Mustafa-Shady/Autonomous_Green_House/README.md

# Autonomous_Green_House
Developing a system that can help farmers optimize crop growth and yield by monitoring and controlling environmental factors like temperature, humidity, and soil moisture using IOT.
