Mustafa-Shady/Autonomous_Green_House/Book _ Presentation/graduation project.pptx

## Autonomous Green House Control System

## Group members

1. Saad Mohammed
2. Mostafa Mohammed
3. Youssef Hamad
4. Mostafa Mahmoud
5. Mohammed Tharwat
6. Mostafa Essam

## Why this project ?

- Greenhouses are important in Egypt due to the country's arid climate, limited water resources, and high population growth, they offer a means of improving crop yields, reducing resource consumption, and providing food security for the growing population.

## Timeline

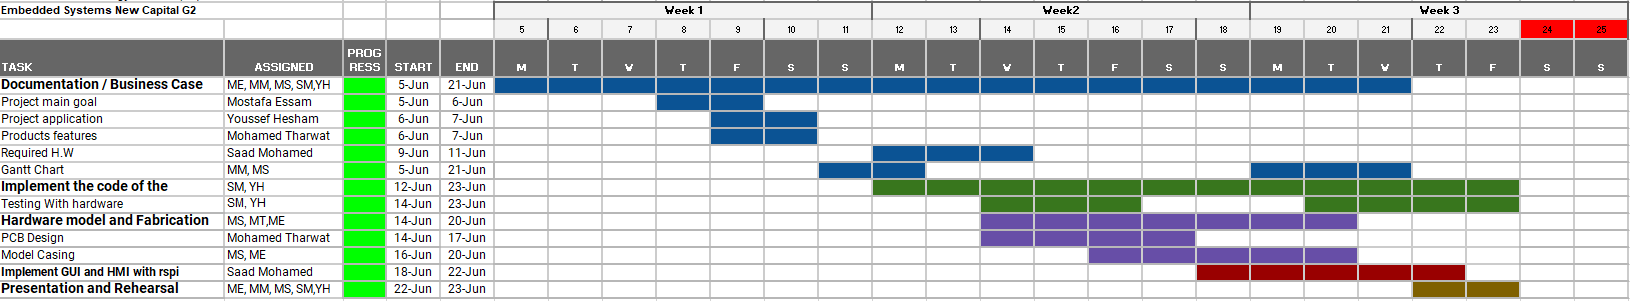
[picture p1: figure]

## Project main goal

- The main goal of this project is to develop a smart greenhouse
system to help users optimize crop growth by monitoring and
controlling environmental factors.

## Project features

1- Automated control: The system uses actuators. such as fans, heaters, and
pumps, to automate controlling of the environment
2- Environmental monitoring: The system uses a network of sensors to monitor
environmental factors such as temperature, humidity, and soil moisture in real-
time and show data on an LCD screen.
3- Remotely monitoring: the system
will send the status of the greenhouse
to an IOT server.

## System Flowchart

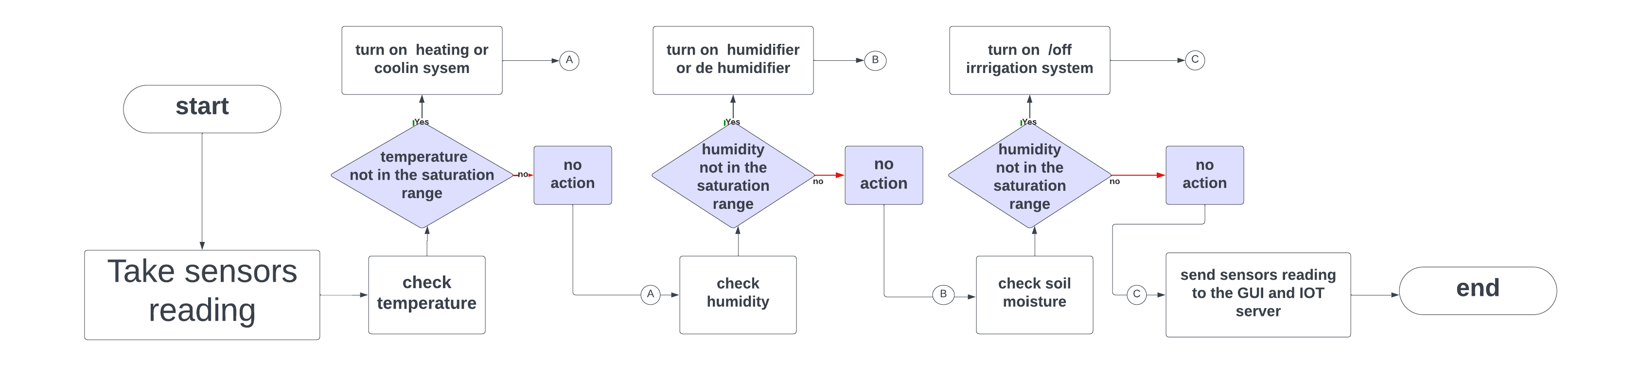
[picture p2: figure]

## Project prototype

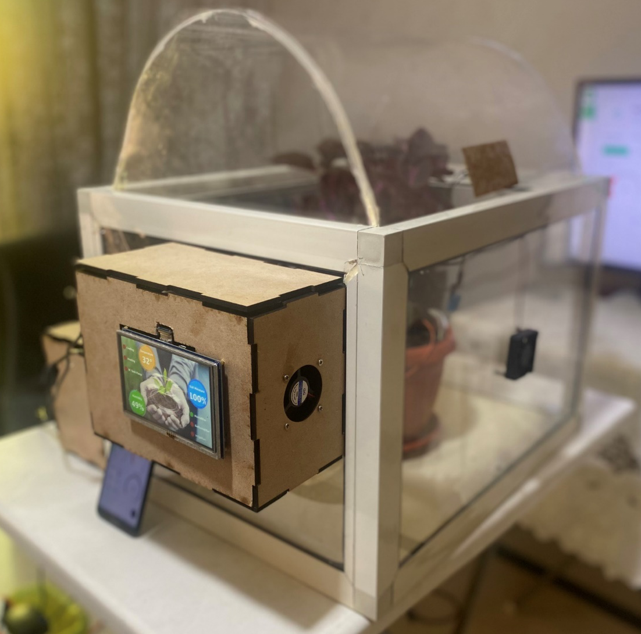
[picture p3: figure]
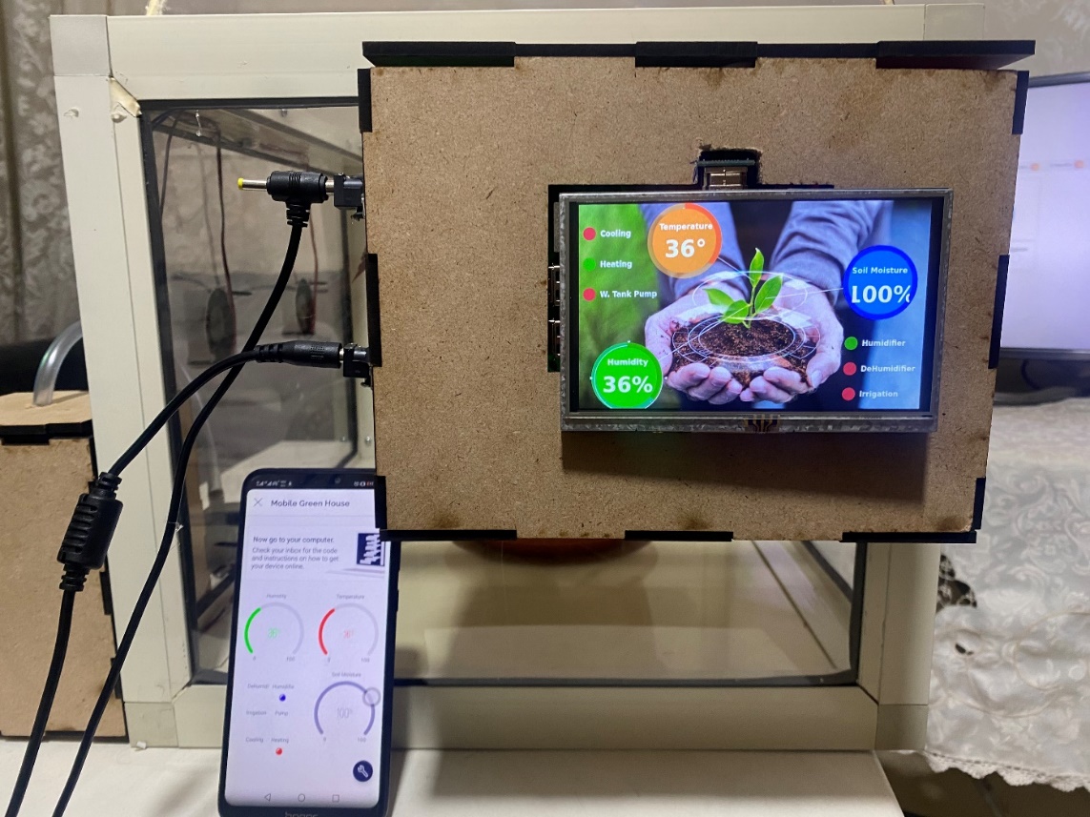
[picture p4: figure]

## Hardware

- Microcontrollers
1-STM32F401CCU6
2-Raspberry Pi 3 Model B+
3- Node Mcu

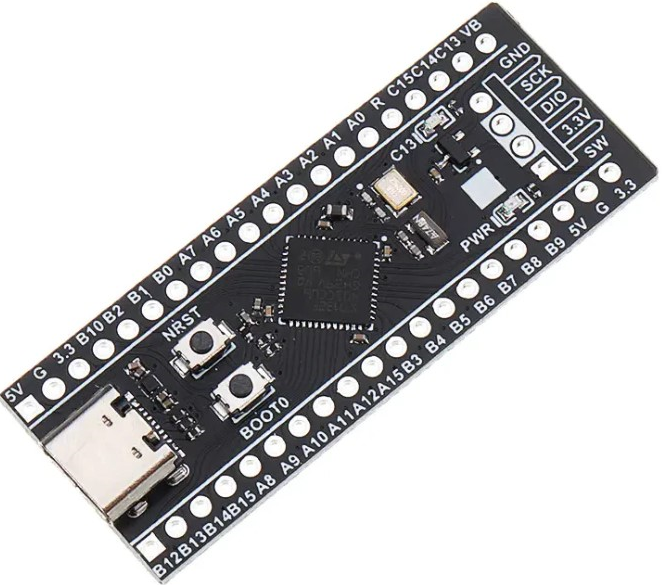
[picture p5: figure]
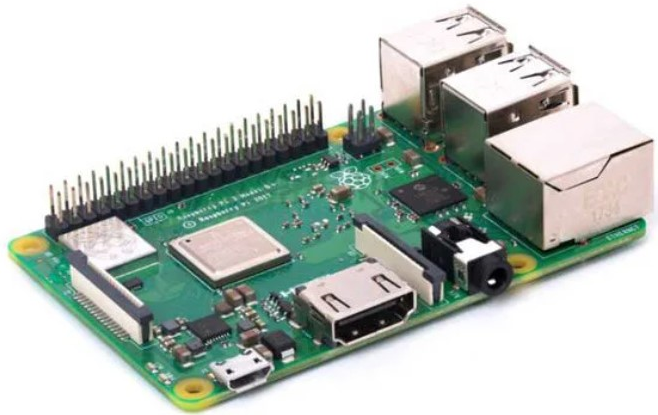
[picture p6: figure]
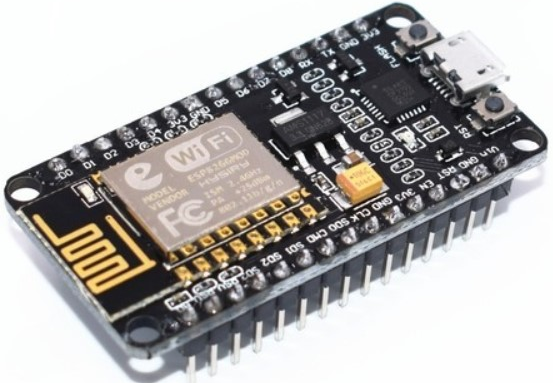
[picture p7: figure]

## Hardware

- Sensors
1- DH11 sensor
2-Soil Moisture Sensor
3-water level sensor

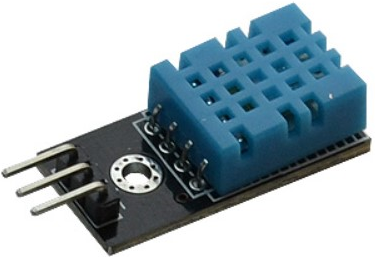
[picture p8: figure]
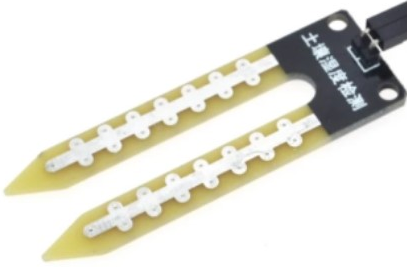
[picture p9: figure]
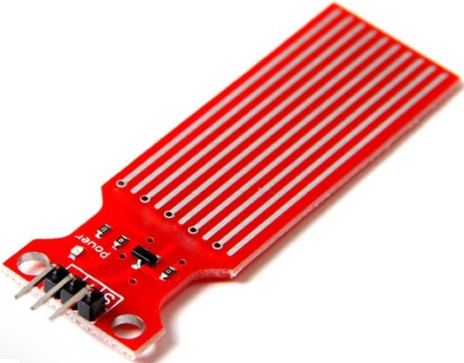
[picture p10: figure]

## Hardware

- Actuators
1-12v Pump
2- 12v fan
3- 5v heating pad

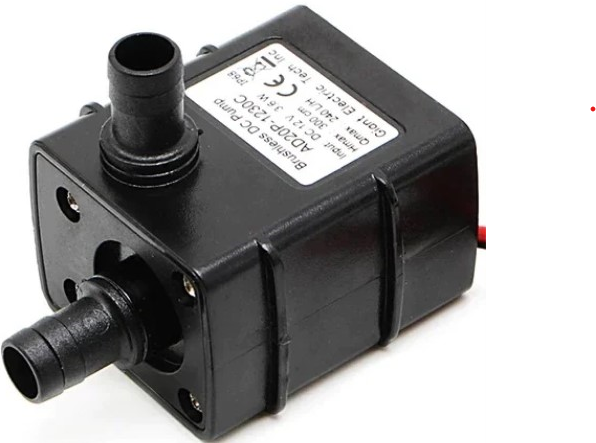
[picture p11: figure]
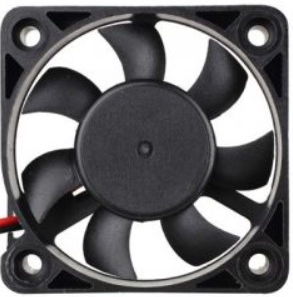
[picture p12: figure]
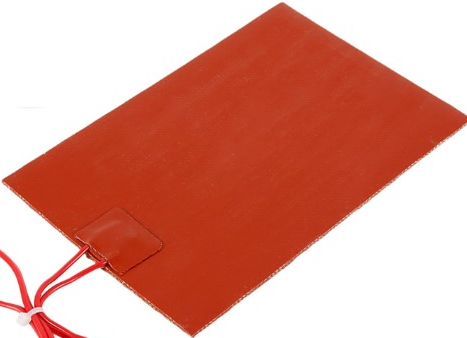
[picture p13: figure]

## Hardware

4- PCB

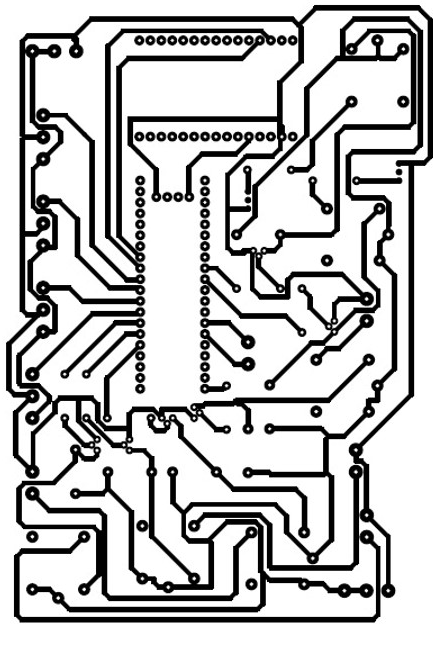
[picture p14: figure]
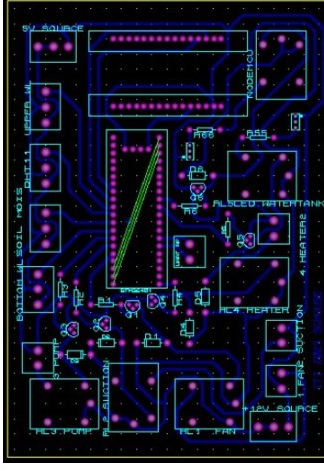
[picture p15: figure]
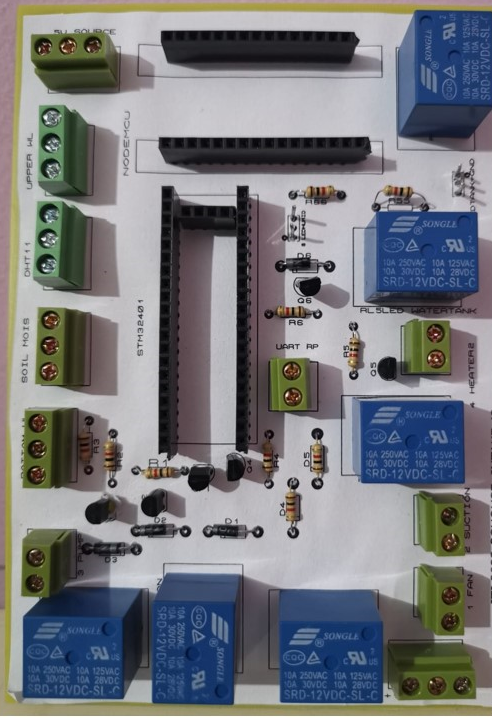
[picture p16: figure]

## Software

  - Three programming languages were used.
1- C language.

- Used to configure STM32F401CCU6 to automate the process and send the data to GUI, IOT systems.
- FreeRTOS was used as an operating system.

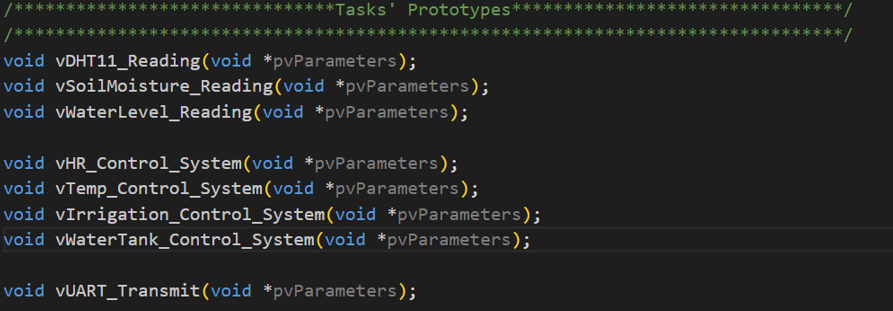
[picture p17: figure]

## Software

2-Python
Used to create the GUI system and update data shown by GUI periodically.

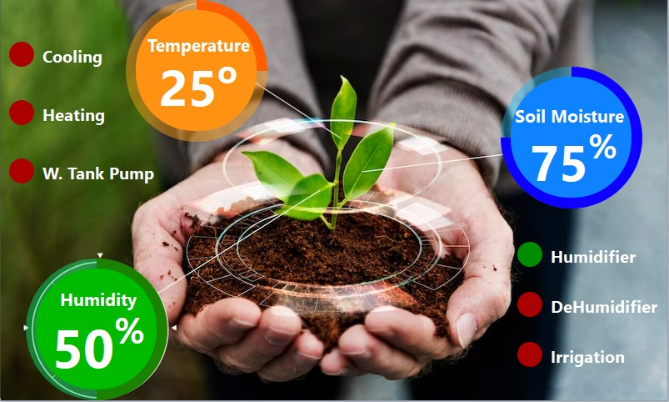
[picture p18: figure]

## Software

3- Arduino C
Set up node MCU to handle communication between STM32F401CCU6 and IOT server.

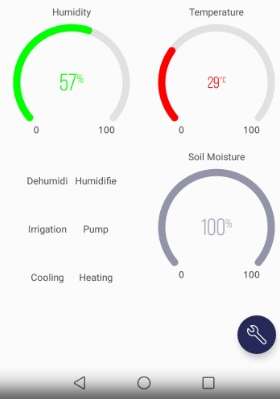
[picture p19: figure]

## Future work

- Add manual mode for the user to control fans, water pump and heaters.
- Add mode for the user to change the system configurations.
- Make these modes available to use through GUI screen and IOT application.

## Test cases

To see test cases press here (https://docs.google.com/spreadsheets/d/1YgNEVHUtksqQ6XoSTe12LOkKqpy5VTSK/edit#gid=343586251)

## Demo video

To see demo video press here (https://drive.google.com/file/d/1VSRbYElWp8d7YfNHoQmX-cIIlgPggJjG/view?usp=drive_link)

## THANKS
