Mustafa-Shady/Autonomous_Green_House/Documents/State Machine Diagram.png

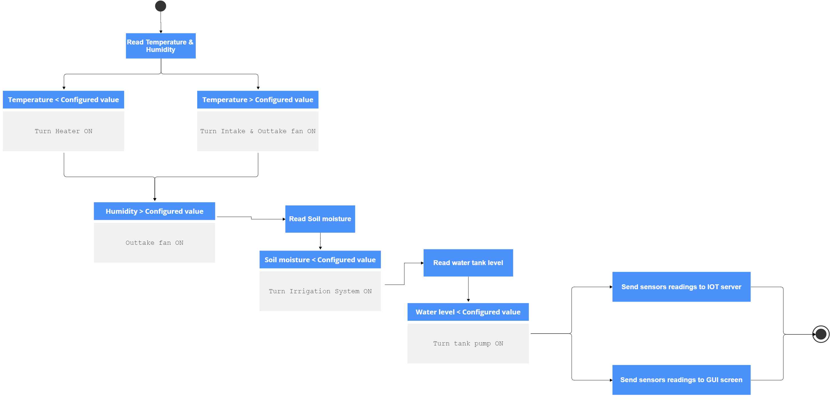
Documents/State Machine Diagram.png
