Mustafa-Shady/Autonomous_Green_House/Documents/Required Hardware.xlsx

No | Qty | Name
1 | 1 | STM32F401
2 | 1 | Soil/Moisture Sensor
3 | 1 | Humdity/Temp Sensor
4 | 2 | Water level Sensors
5 | 1 | Water Pump
6 | 1 | Plant pot
7 | 1 | Rasp Pi B Model
8 | 1 | LCD HMI Screen
9 | 1 | WIFI Module
10 | 4 | Relays
