Mustafa-Shady/Autonomous_Green_House/Documents/Project budget_.xlsx

No. | Qty | Name | Price | Total
1 | 1 | STM32F401 | 300 | 300
2 | 1 | Soil/Moisture Sensor | 190 | 190
3 | 1 | Humdity/Temp Sensor | 175 | 175
4 | 2 | Water level Sensors | 40 | 80
5 | 1 | Water Pump | 90 | 90
6 | 1 | Plant pot | 200 | 200
7 | 1 | Rasp Pi B Model | 6000 | 6000
8 | 1 | LCD HMI Screen | 2000 | 2000
9 | 1 | WIFI Module | 300 | 300
10 | 4 | Relays | 45 | 180
11 | 1 | Casing(Packaging) | 350 | 350
Total |  |  |  | 9865
