Mustafa-Shady/Autonomous_Green_House/Documents/Test_Cases.xlsx

Test case ID. | Test Case Description | Test Steps | Test Data | Expected Results | Actual Results | Pass/Fail
SY01 | Check Irrigation System Activation | Apply SoilMoisture Sensor to a dry Soil. | soil with Moisture Less than 40% | Activation of Irrigation System | As Expected | Pass
SY02 | Check Irrigation System Deactivation | Apply SoilMoisture Sensor to a wet Soil. | soil with Moisture More than 80% | Deactivation of Irrigation System | As Expected | Pass
SY03 | Check Humidifier System Activation | Apply DH11 Sensor to a dry atmosphere. | Atmosphere with Humidity less than 40% | Activation of Humidifier System | As Expected | Pass
SY04 | Check Humidifier System DeActivation | Apply DH11 Sensor to a Less Dry atmosphere. | Atmosphere with Humidity less than 50% | Deactivation of Humidifier System | As Expected | Pass
SY05 | Check Dehumidifier System Activation | Apply DH11 Sensor to a wet atmosphere. | Atmosphere with Humidity More than 70% | Activation of Dehumidifier System | As Expected | Pass
SY06 | Check Dehumidifier System Deactivation | Apply DH11 Sensor to a Less wet atmosphere. | Atmosphere with Humidity Less than 60% | Decativation of Dehumidifier System | As Expected | Pass
SY07 | Check Cooling System Activation | Apply DH11 Sensor to a high temp. atmosphere | Atmosphere with Temp. More than 40°C | Activation of Cooling System | As Expected | Pass
SY08 | Check Cooling System Deactivation | Apply DH11 Sensor to a lower temp. atmosphere | Atmosphere with Temp. of 35°C | Deactivation of Cooling System | As Expected | Pass
SY09 | Check Heating System Activation | Apply DH11 Sensor to a low temp. atmosphere | Atmosphere with Temp. of less than 30°C | Activation of Heating System | As Expected | Pass
SY10 | Check Heating System Deactivation | Apply DH11 Sensor to a higher temp. atmosphere | Atmosphere with Temp. of 35°C | Deactivation of Heating System | As Expected | Pass
SY11 | Check Water Tank System Activation | Fill the water Tank with little water Amount | Filling Water Tank with less than 20% | Activation of Water Tank System | As Expected | Pass
SY12 | Check Water Tank System Deactivation | Fill the water Tank with large water Amount | Filling Water Tank with More than 80% | Deactivation of Water Tank System | As Expected | Pass
GUI01 | Check SoilMoisture Gage functionality | Apply Range of data to the Sensor | Apply range of data between 0-100% | The GUI gage will Show the same values as shown in the debugging system | As Expected | Pass
GUI02 | Check Humidity Gage functionality | Apply Range of data to the Sensor | Apply range of data between 30-80% | The GUI gage will Show the same values as shown in the debugging system | As Expected | Pass
GUI03 | Check Temp. Gage functionality | Apply Range of data to the Sensor | Apply range of data between 20°C-50°C | The GUI gage will Show the same values as shown in the debugging system | As Expected | Pass
GUI04 | Check Irrigation System indicator Activation | Apply SoilMoisture Sensor to a dry Soil. | soil with Moisture Less than 40% | Irrigation System indicator Turn Green | As Expected | Pass
GUI05 | Check Irrigation System indicator Deactivation | Apply SoilMoisture Sensor to a wet Soil. | soil with Moisture More than 80% | Irrigation System indicator Turn Red | As Expected | Pass
GUI06 | Check Humidifier System Indicator Activation | Apply DH11 Sensor to a dry atmosphere. | Atmosphere with Humidity less than 40% | Humidifier System Indicator Turn Green | As Expected | Pass
GUI07 | Check Humidifier System Indicator DeActivation | Apply DH11 Sensor to a Less Dry atmosphere. | Atmosphere with Humidity less than 50% | Humidifier System Indicator Turn Red | As Expected | Pass
GUI08 | Check Dehumidifier System Indicator Activation | Apply DH11 Sensor to a wet atmosphere. | Atmosphere with Humidity More than 70% | Dehumidifier System Indicator Turn Green | As Expected | Pass
GUI09 | Check Dehumidifier System Indicator Deactivation | Apply DH11 Sensor to a Less wet atmosphere. | Atmosphere with Humidity Less than 60% | Dehumidifier System Indicator Turn Red | As Expected | Pass
GUI10 | Check Cooling System Indicator Activation | Apply DH11 Sensor to a high temp. atmosphere | Atmosphere with Temp. More than 40°C | Cooling System Indicator Turn Green | As Expected | Pass
GUI11 | Check Cooling System Indicator Deactivation | Apply DH11 Sensor to a lower temp. atmosphere | Atmosphere with Temp. of 35°C | Cooling System Indicator Turn Red | As Expected | Pass
GUI12 | Check Heating System Indicator Activation | Apply DH11 Sensor to a low temp. atmosphere | Atmosphere with Temp. of less than 30°C | Heating System Indicator Turn Green | As Expected | Pass
GUI13 | Check Heating System Indicator Deactivation | Apply DH11 Sensor to a higher temp. atmosphere | Atmosphere with Temp. of 35°C | Heating System Indicator Turn Red | As Expected | Pass
GUI14 | Check Water Tank System Indicator Activation | Fill the water Tank with little water Amount | Filling Water Tank with less than 20% | Water Tank System Indicator Turn Green | As Expected | Pass
GUI15 | Check Water Tank System Indicator Deactivation | Fill the water Tank with large water Amount | Filling Water Tank with More than 80% | Water Tank System Indicator Turn Red | As Expected | Pass
IOT01 | Check SoilMoisture Gage functionality | Apply Range of data to the Sensor | Apply range of data between 0-100% | The IOT gage will Show the same values as shown in the debugging system | As Expected | Pass
IOT02 | Check Humidity Gage functionality | Apply Range of data to the Sensor | Apply range of data between 30-80% | The IOT gage will Show the same values as shown in the debugging system | As Expected | Pass
IOT03 | Check Temp. Gage functionality | Apply Range of data to the Sensor | Apply range of data between 20°C-50°C | The IOT gage will Show the same values as shown in the debugging system | As Expected | Pass
IOT04 | Check Irrigation System indicator Activation | Apply SoilMoisture Sensor to a dry Soil. | soil with Moisture Less than 40% | Irrigation System indicator Appear | As Expected | Pass
IOT05 | Check Irrigation System indicator Deactivation | Apply SoilMoisture Sensor to a wet Soil. | soil with Moisture More than 80% | Irrigation System indicator Disappear | As Expected | Pass
IOT06 | Check Humidifier System Indicator Activation | Apply DH11 Sensor to a dry atmosphere. | Atmosphere with Humidity less than 40% | Humidifier System Indicator Appear | As Expected | Pass
IOT07 | Check Humidifier System Indicator DeActivation | Apply DH11 Sensor to a Less Dry atmosphere. | Atmosphere with Humidity less than 50% | Humidifier System Indicator Disappear | As Expected | Pass
IOT08 | Check Dehumidifier System Indicator Activation | Apply DH11 Sensor to a wet atmosphere. | Atmosphere with Humidity More than 70% | Dehumidifier System Indicator Appear | As Expected | Pass
IOT09 | Check Dehumidifier System Indicator Deactivation | Apply DH11 Sensor to a Less wet atmosphere. | Atmosphere with Humidity Less than 60% | Dehumidifier System Indicator Disappear | As Expected | Pass
IOT10 | Check Cooling System Indicator Activation | Apply DH11 Sensor to a high temp. atmosphere | Atmosphere with Temp. More than 40°C | Cooling System Indicator Appear | As Expected | Pass
IOT11 | Check Cooling System Indicator Deactivation | Apply DH11 Sensor to a lower temp. atmosphere | Atmosphere with Temp. of 35°C | Cooling System Indicator Disappear | As Expected | Pass
IOT12 | Check Heating System Indicator Activation | Apply DH11 Sensor to a low temp. atmosphere | Atmosphere with Temp. of less than 30°C | Heating System Indicator Appear | As Expected | Pass
IOT13 | Check Heating System Indicator Deactivation | Apply DH11 Sensor to a higher temp. atmosphere | Atmosphere with Temp. of 35°C | Heating System Indicator Disappear | As Expected | Pass
IOT14 | Check Water Tank System Indicator Activation | Fill the water Tank with little water Amount | Filling Water Tank with less than 20% | Water Tank System Indicator Appear | As Expected | Pass
IOT15 | Check Water Tank System Indicator Deactivation | Fill the water Tank with large water Amount | Filling Water Tank with More than 80% | Water Tank System Indicator Disappear | As Expected | Pass
