Mustafa-Shady/Autonomous_Green_House/Documents/System Diagram.pdf

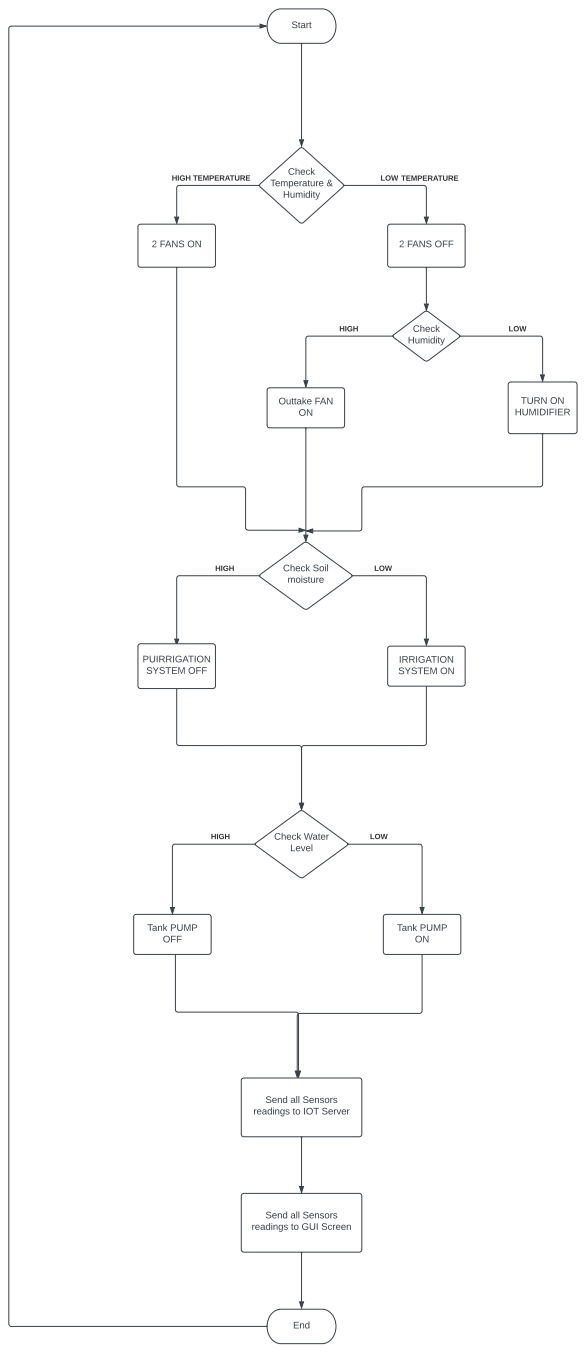
[picture p54: page 1]
Start; End; Check Temperature & Humidity; HIGH TEMPERATURE; LOW; Check Humidity; HIGH; Check Soil moisture; 2 FANS ON; 2 FANS OFF; Outtake FAN ON; PUIRRIGATION SYSTEM OFF; IRRIGATION SYSTEM ON; Check Water Level; Tank PUMP OFF; Tank PUMP ON; TEMPERATURE; TURN ON HUMIDIFIER

Send all Sensors
readings to IOT Server

readings to GUI Screen
