Mustafa-Shady/Autonomous_Green_House/Final_Project_Demo_1.ioc

Mcu.UserName=STM32F401CCUx
PA10.Signal=USART1_RX
PA13.Signal=SYS_JTMS-SWDIO
PA14.Signal=SYS_JTCK-SWCLK
PA2.Signal=USART2_TX
PA3.Signal=USART2_RX
PA4.Signal=ADCx_IN4
PA5.Signal=GPIO_Output
PA6.Signal=ADCx_IN6
PA9.Signal=USART1_TX
PB0.Signal=GPIO_Output
PB1.Signal=GPIO_Output
PB10.Signal=GPIO_Output
PB12.Signal=GPIO_Output
PB5.Signal=GPIO_Output
PB6.Signal=GPIO_Output
